herrjacob48-ui/fuzz-pedal/docs/fuzz_pedal_schematic_cropped.pdf

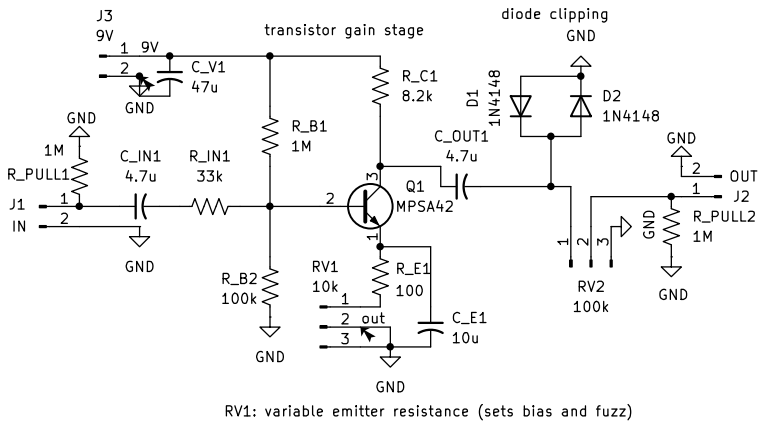
[picture p7: page 1]
