herrjacob48-ui/fuzz-pedal/hardware/fuzz_pedal.kicad_pcb

## KiCad design hardware/fuzz_pedal.kicad_pcb (2026-10-11)

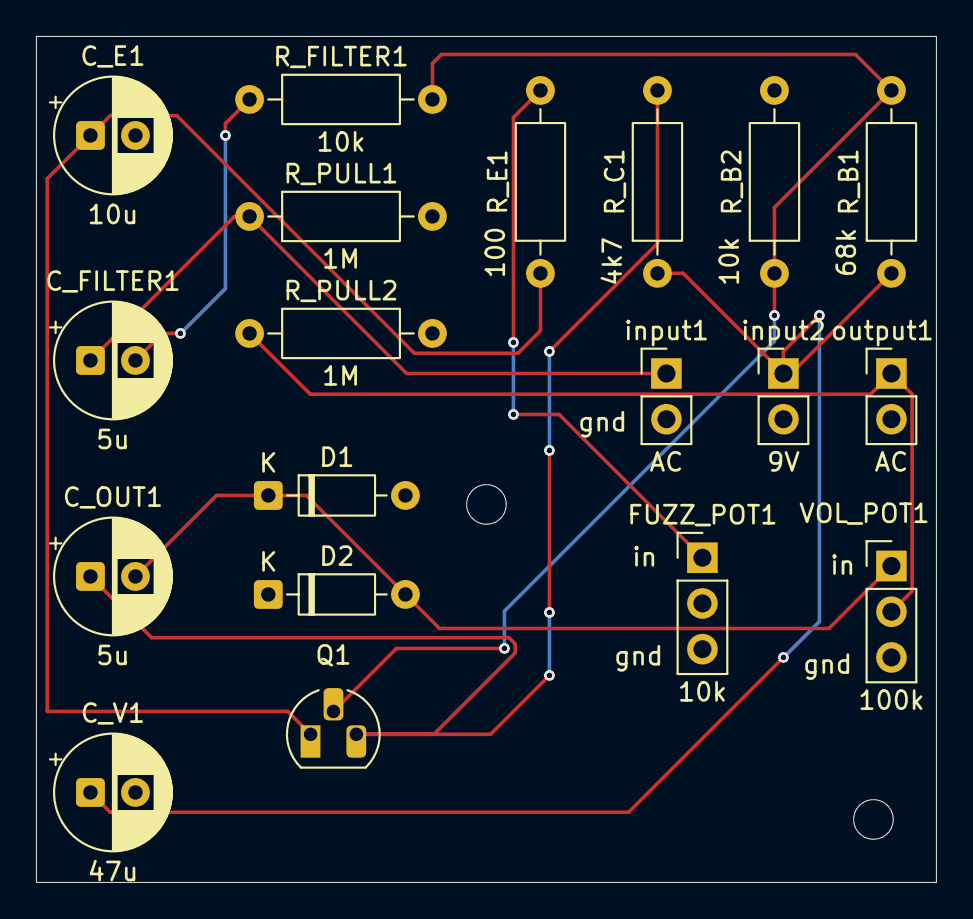
[picture p8: board fuzz_pedal.kicad_pcb from above]

Board: 2 copper layers, 50.0 x 47.0 mm, 19 parts (0 on the bottom side), 10 nets.

Parts:
C_E1: 10u; CP_Radial_D6.3mm_P2.50mm
C_FILTER1: 5u; CP_Radial_D6.3mm_P2.50mm
C_OUT1: 5u; CP_Radial_D6.3mm_P2.50mm
C_V1: 47u; CP_Radial_D6.3mm_P2.50mm
D1, D2: 1N4148; D_DO-35_SOD27_P7.62mm_Horizontal
FUZZ_POT1: 10k; PinHeader_1x03_P2.54mm_Vertical
Q1: MPSA42; TO-92_HandSolder
R_B1: 68k; R_Axial_DIN0207_L6.3mm_D2.5mm_P10.16mm_Horizontal
R_B2: 10k; R_Axial_DIN0207_L6.3mm_D2.5mm_P10.16mm_Horizontal
R_C1: 4k7; R_Axial_DIN0207_L6.3mm_D2.5mm_P10.16mm_Horizontal
R_E1: 100; R_Axial_DIN0207_L6.3mm_D2.5mm_P10.16mm_Horizontal
R_FILTER1: 10k; R_Axial_DIN0207_L6.3mm_D2.5mm_P10.16mm_Horizontal
R_PULL1, R_PULL2: 1M; R_Axial_DIN0207_L6.3mm_D2.5mm_P10.16mm_Horizontal
VOL_POT1: 100k; PinHeader_1x03_P2.54mm_Vertical
input1: AC; PinHeader_1x02_P2.54mm_Vertical
input2: 9V; PinHeader_1x02_P2.54mm_Vertical
output1: AC; PinHeader_1x02_P2.54mm_Vertical

Connections:
/9V: C_V1.1, R_B1.1, R_C1.1, input2.1
GND: C_E1.2, C_V1.2, D1.2 (A), D2.1 (K), FUZZ_POT1.2, FUZZ_POT1.3, R_B2.2, R_PULL1.2, R_PULL2.2, VOL_POT1.3, input1.2, input2.2, output1.2
unnamed: C_FILTER1.2, R_FILTER1.1
unnamed: C_OUT1.2, D1.1 (K), D2.2 (A), VOL_POT1.1
unnamed: FUZZ_POT1.1, R_E1.2
unnamed: Q1.2 (B), R_B1.2, R_B2.1, R_FILTER1.2
unnamed: C_OUT1.1, Q1.3 (C), R_C1.2
unnamed: C_E1.1, Q1.1 (E), R_E1.1
unnamed: R_PULL2.1, VOL_POT1.2, output1.1
unnamed: C_FILTER1.1, R_PULL1.1, input1.1
