herrjacob48-ui/fuzz-pedal/(commit log)

2026-10-11 added schematic docs, pcb screenshots, and protoype images to the repo. Added simulation files for the fuzz pedal circuit.
    [fuzz_pedal.kicad_sch, fuzz_pedal_sim.kicad_sch]
2026-10-11 added mp3 demo of final prototype
2026-10-11 added pcb file
    [fuzz_pedal.kicad_pcb]
