herrjacob48-ui/fuzz-pedal/images/Oscilliscope_testing.jpeg

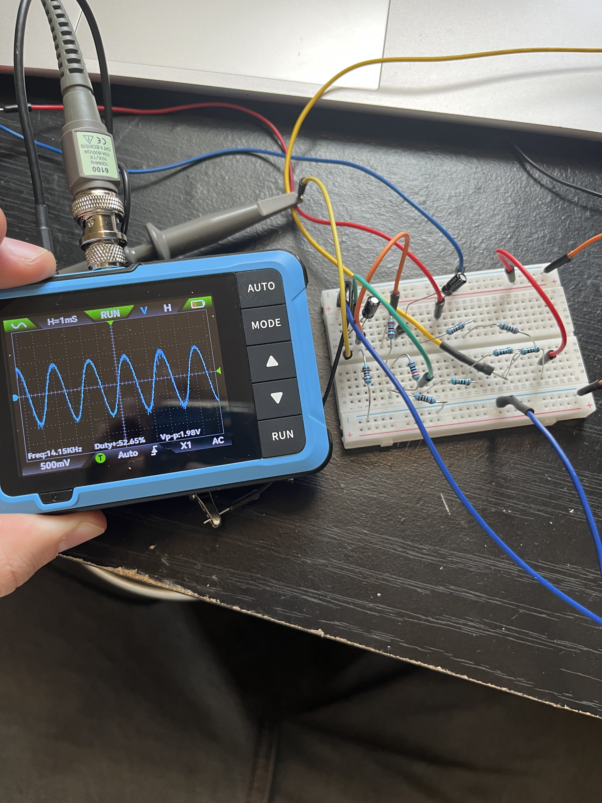
[picture p5: images/Oscilliscope_testing.jpeg]
images/Oscilliscope_testing.jpeg
